Alegnago/cockpit/video_frames/video_contrasto.jpg

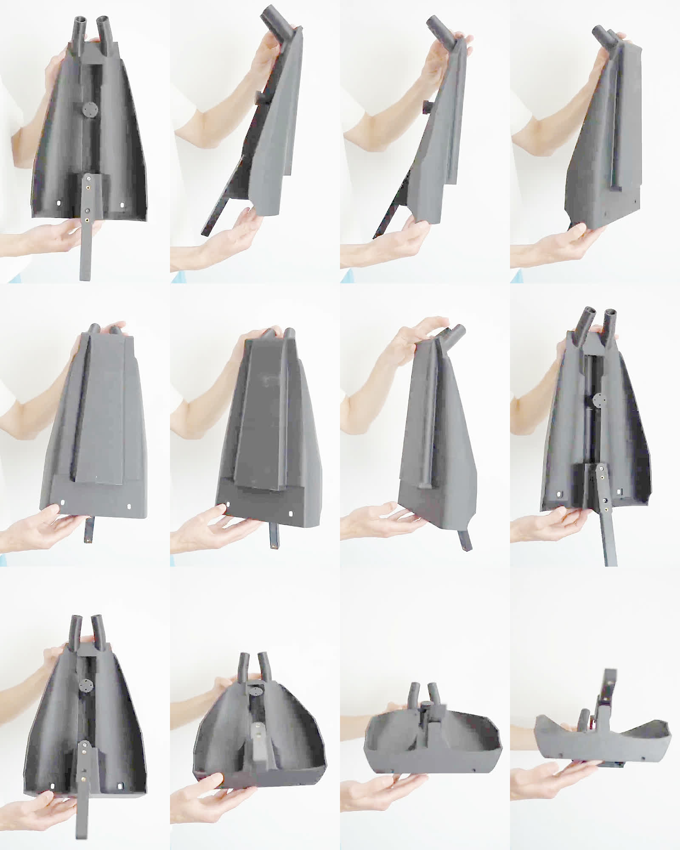
video_frames/video_contrasto.jpg
