Alegnago/cockpit/viewer/ref/sotto.jpg

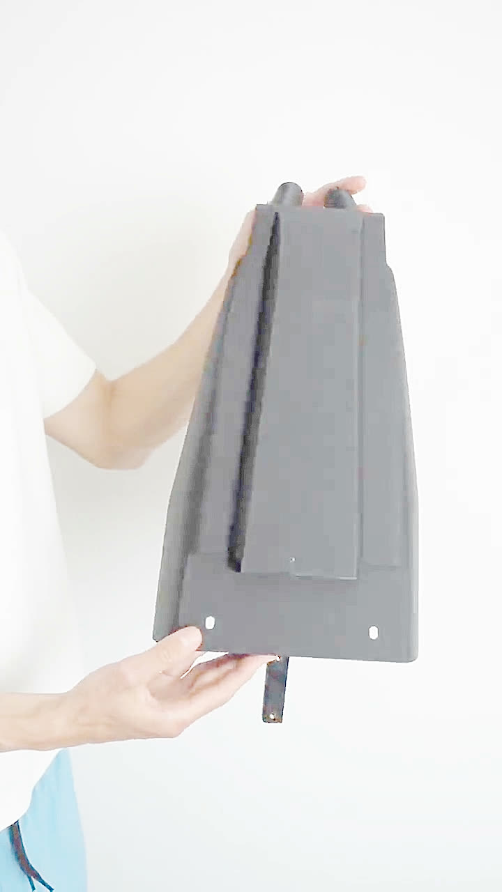
viewer/ref/sotto.jpg
