Alegnago/cockpit/out/assieme_front.png

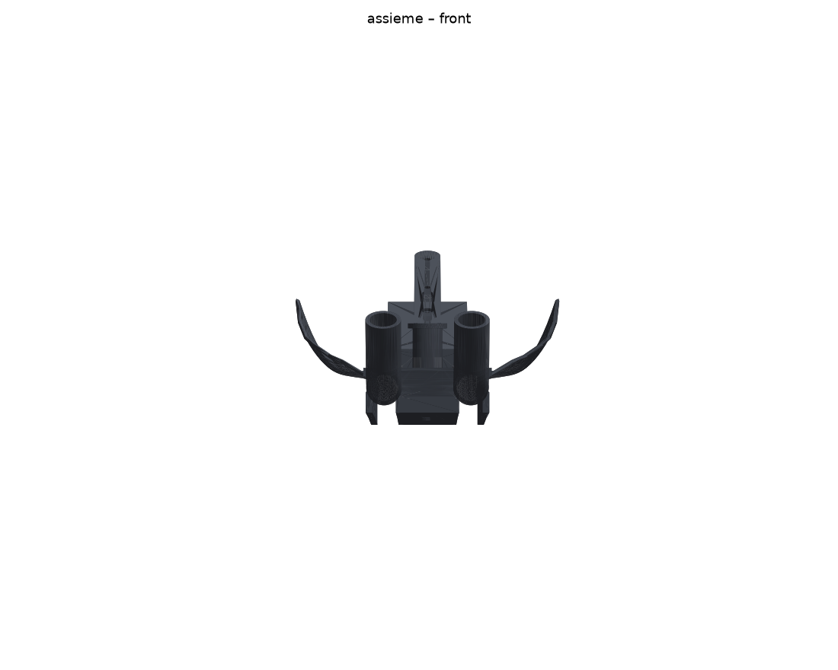
out/assieme_front.png
