Alegnago/cockpit/out/assieme_iso.png

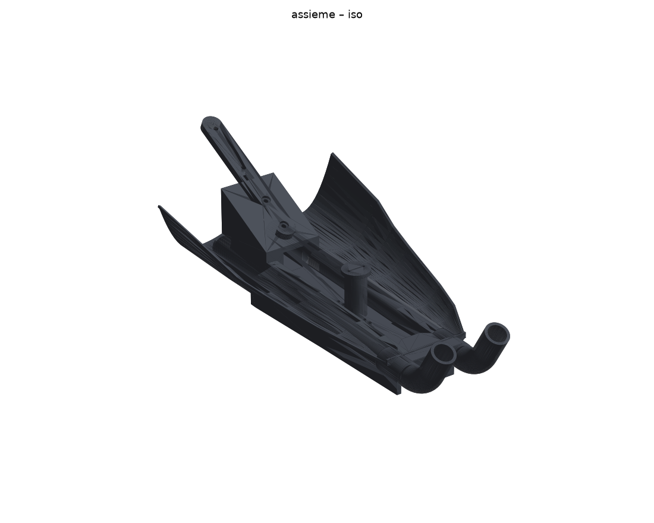
out/assieme_iso.png
