Alegnago/cockpit/out/assieme_side.png

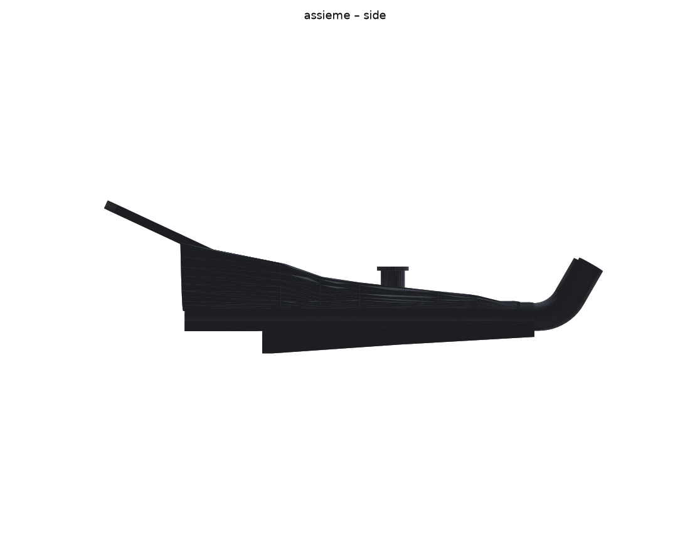
out/assieme_side.png
