Alegnago/cockpit/out/assieme_top.png

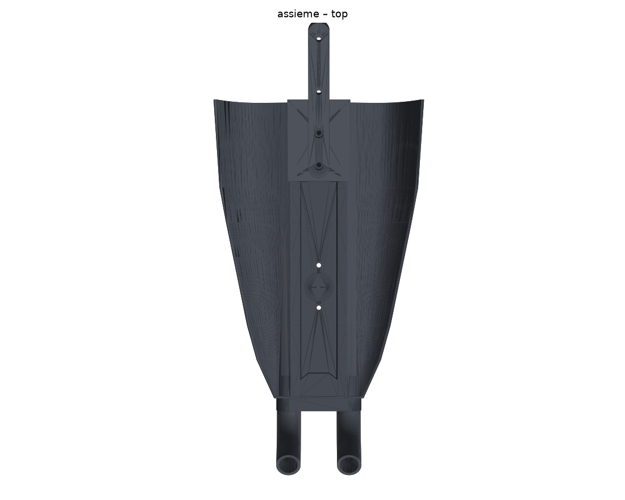
out/assieme_top.png
