Alegnago/cockpit/out/assieme_under.png

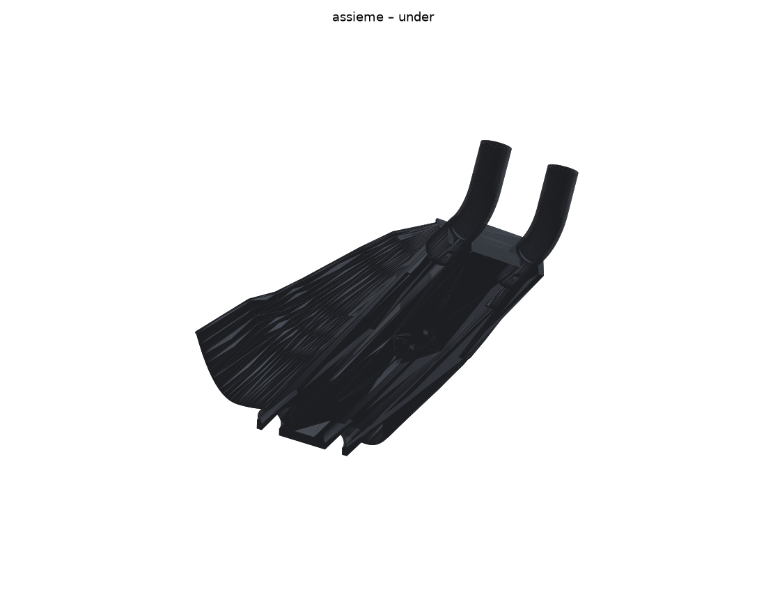
out/assieme_under.png
