Alegnago/cockpit/out/P3_tubo_punta_dx_front.png

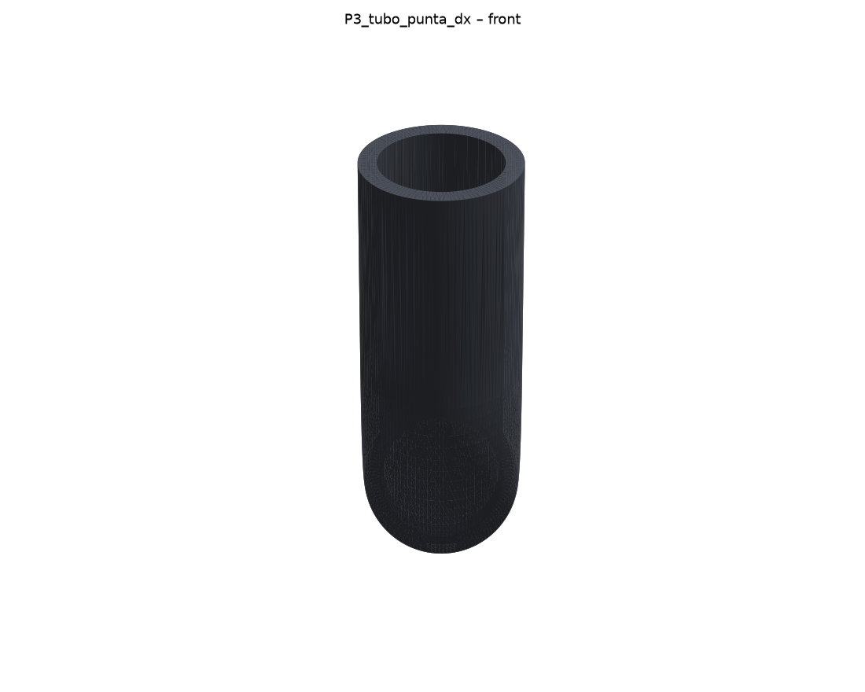
out/P3_tubo_punta_dx_front.png
