Alegnago/cockpit/out/P3_tubo_punta_dx_iso.png

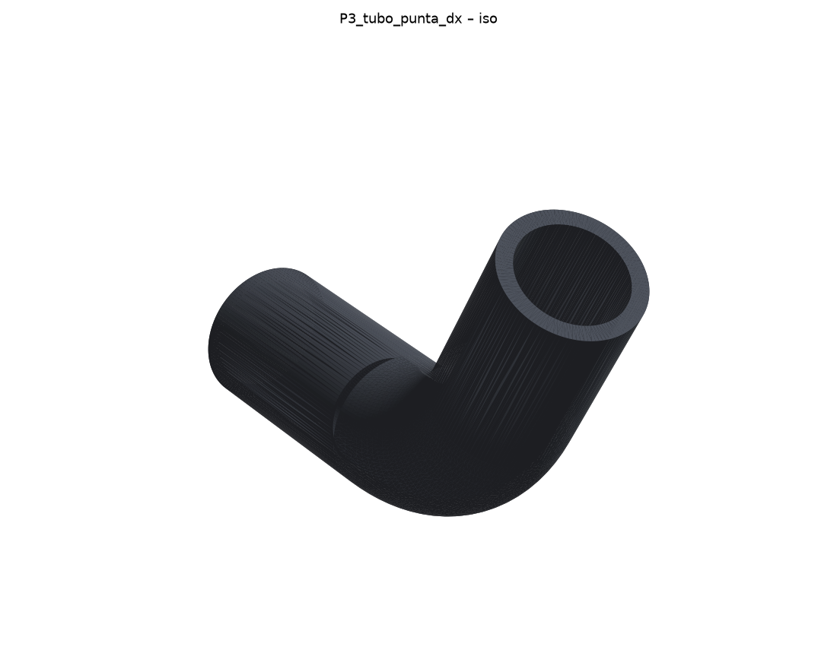
out/P3_tubo_punta_dx_iso.png
