Alegnago/cockpit/out/P3_tubo_punta_dx_side.png

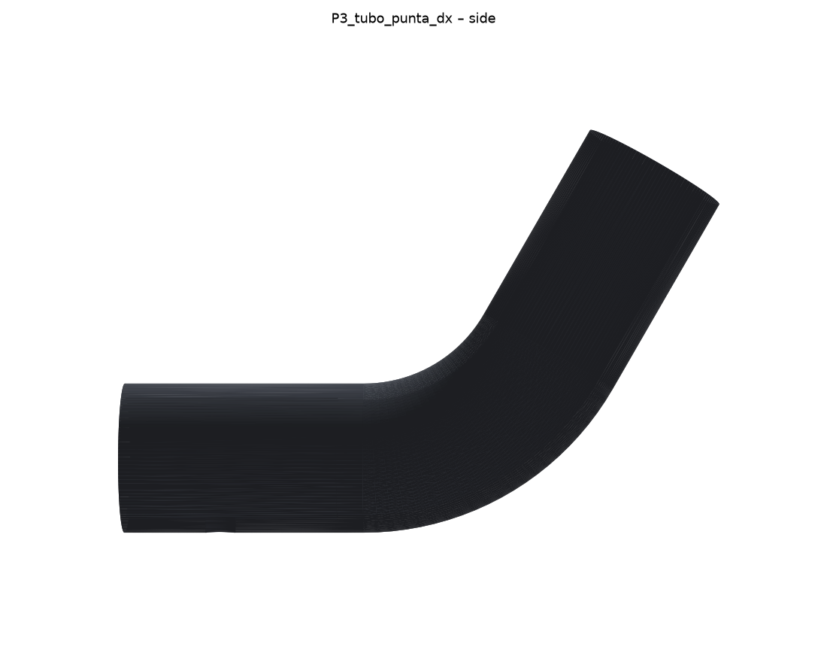
out/P3_tubo_punta_dx_side.png
