Alegnago/cockpit/out/P3_tubo_punta_dx_under.png

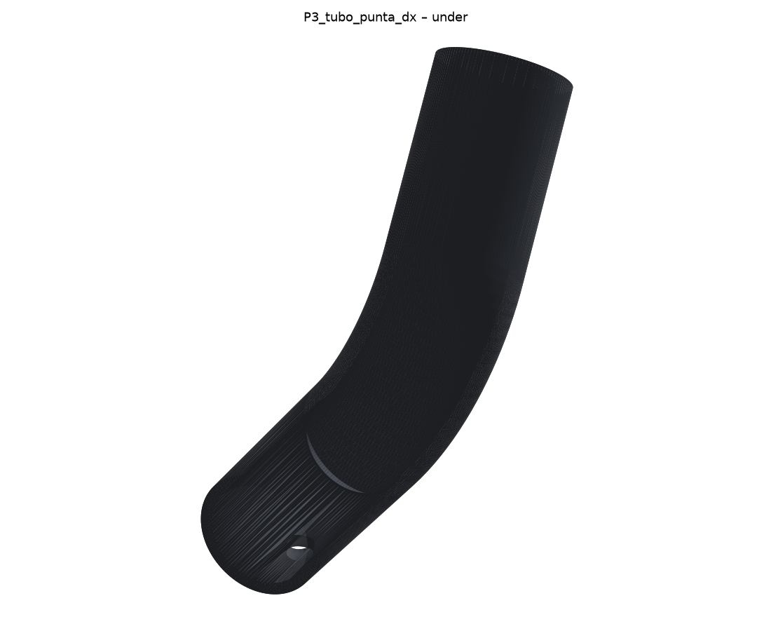
out/P3_tubo_punta_dx_under.png
