Alegnago/cockpit/video_frames/confronto_lato.jpg

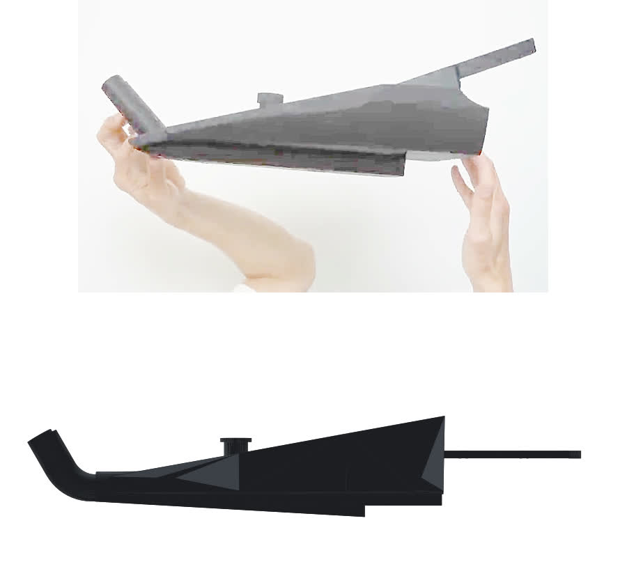
video_frames/confronto_lato.jpg
