Alegnago/cockpit/viewer/ref/alto.jpg

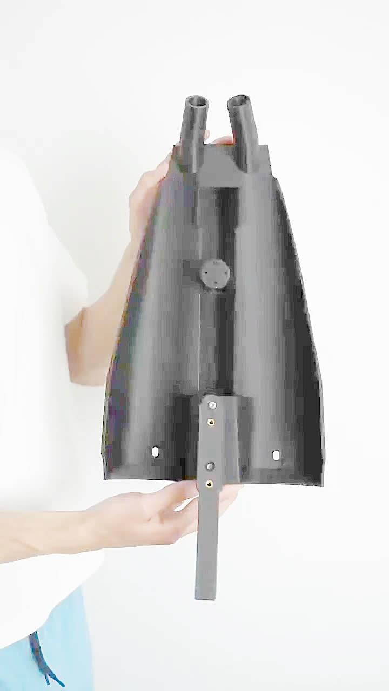
viewer/ref/alto.jpg
