Alegnago/cockpit/viewer/ref/lato.jpg

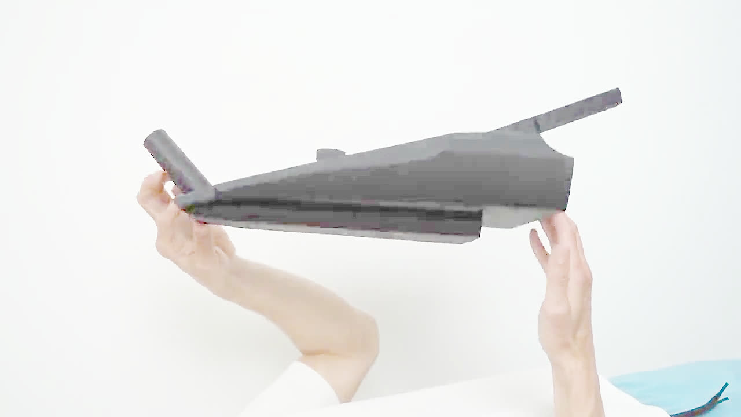
viewer/ref/lato.jpg
