Alegnago/cockpit/out/P0_test_clip.step

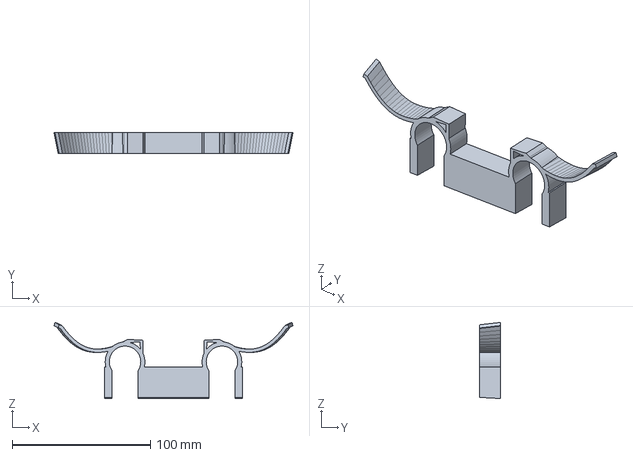
[picture p15: CAD file, 2026-10-28]
out/P0_test_clip.step
172.7 x 15.0 x 55.0 mm
