Alegnago/cockpit/out/P2_vassoio_posteriore.step

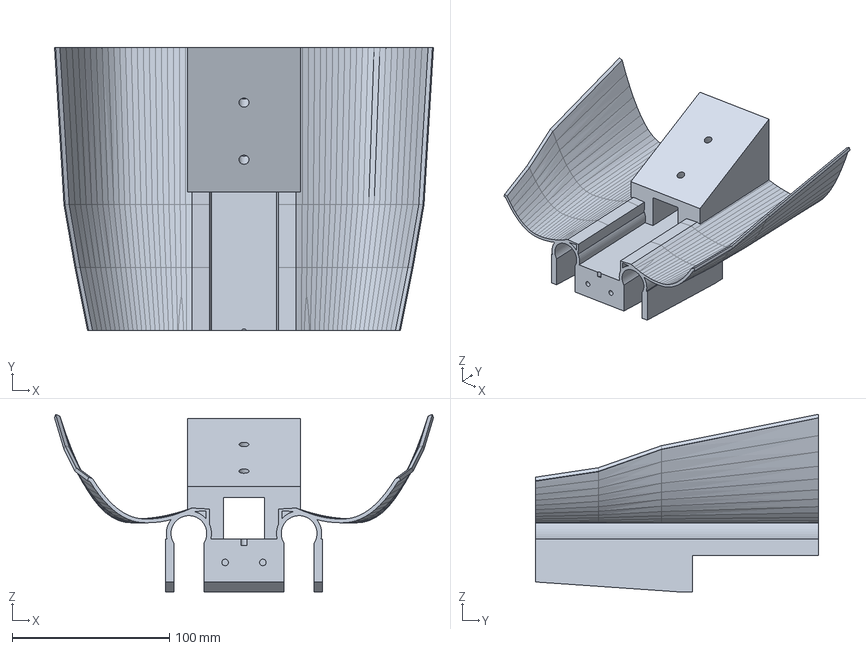
[picture p16: CAD file, 2026-10-28]
out/P2_vassoio_posteriore.step
240.7 x 180.0 x 112.7 mm
