Alegnago/cockpit/out/assieme.step

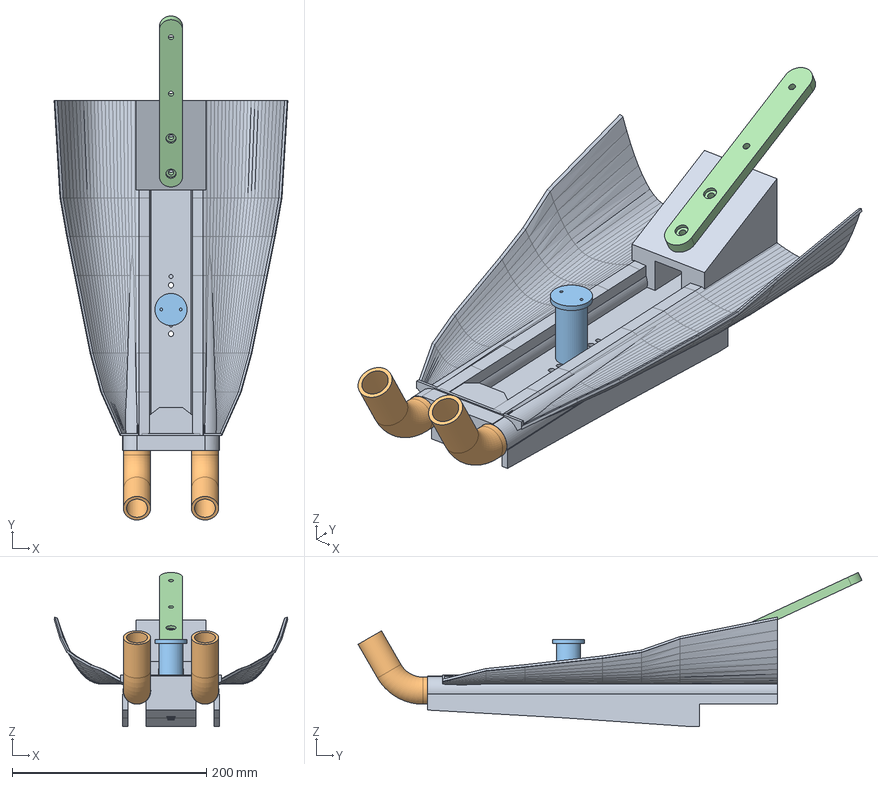
[picture p17: CAD file, 2026-10-28]
out/assieme.step
240.7 x 519.0 x 158.7 mm
