Alegnago/cockpit/out/P3_tubo_punta_sx.step

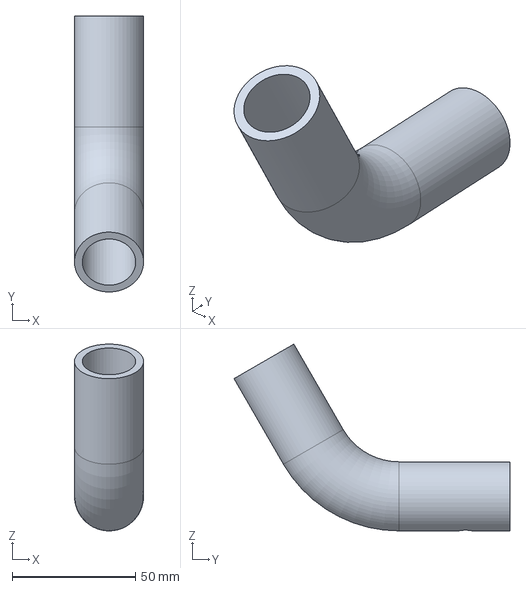
[picture p18: CAD file, 2026-10-28]
out/P3_tubo_punta_sx.step
28.0 x 111.8 x 75.6 mm
