Alegnago/cockpit/out/P5_braccio_borraccia.step

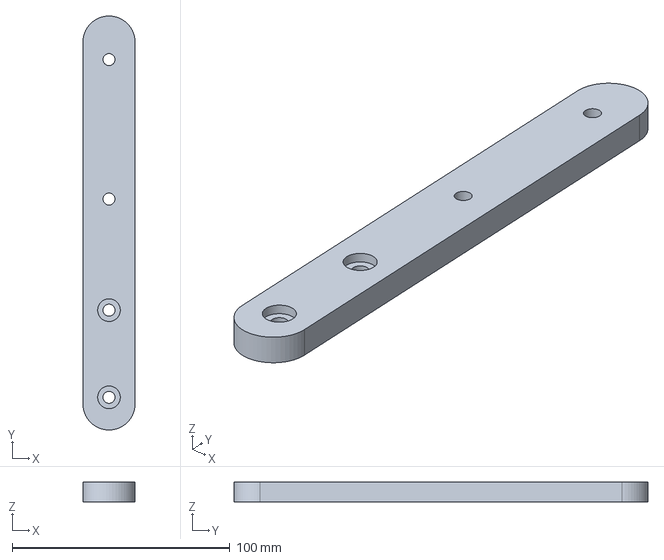
[picture p19: CAD file, 2026-10-28]
out/P5_braccio_borraccia.step
24.0 x 190.0 x 9.00 mm
