Alegnago/cockpit/out/P4_colonnina_computer.step

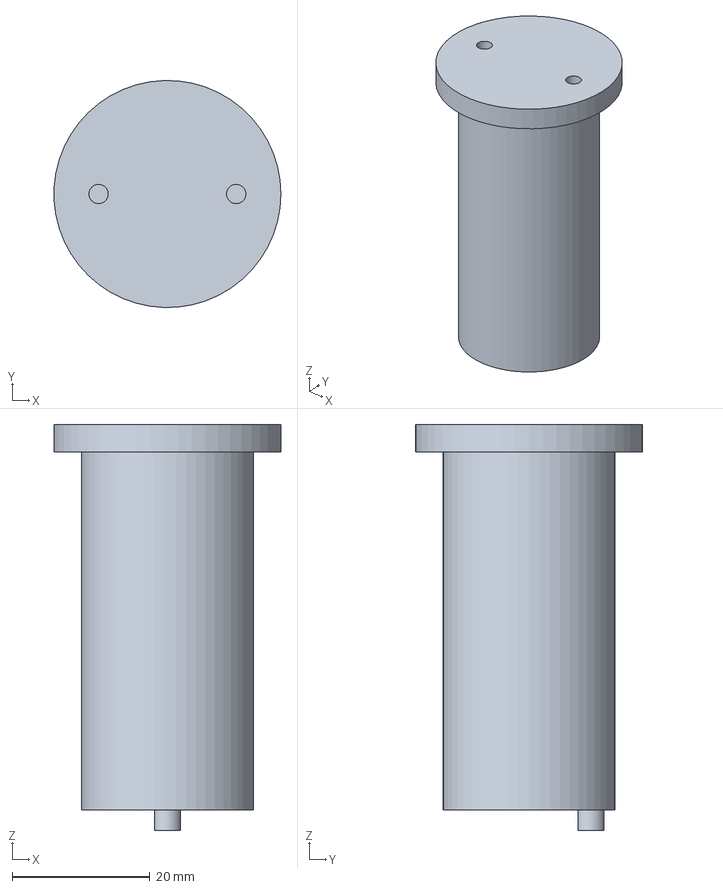
[picture p20: CAD file, 2026-10-28]
out/P4_colonnina_computer.step
33.0 x 33.0 x 59.0 mm
