Alegnago/cockpit/out/P1_vassoio_anteriore.step

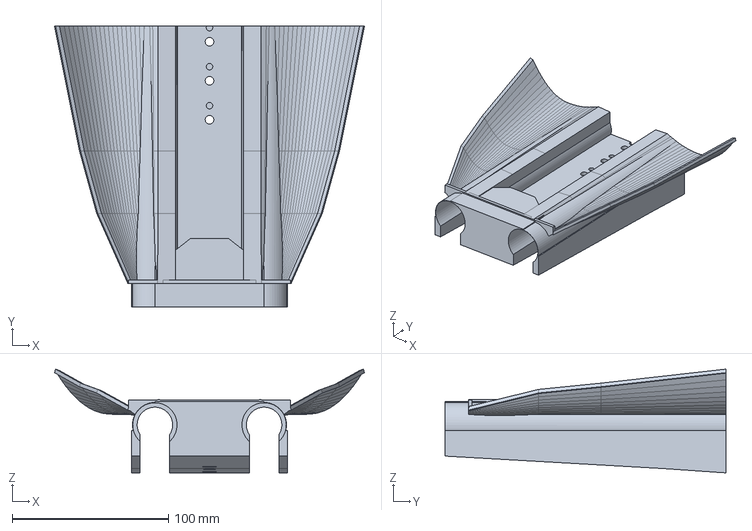
[picture p21: CAD file, 2026-10-28]
out/P1_vassoio_anteriore.step
198.7 x 180.0 x 66.5 mm
