Alegnago/cockpit/(list of files, cad)

Other CAD files:
out/P3_tubo_punta_dx.step
out/P0_test_clip.stl
out/P1_vassoio_anteriore.stl
out/P2_vassoio_posteriore.stl
out/P3_tubo_punta_dx.stl
out/P3_tubo_punta_sx.stl
out/P4_colonnina_computer.stl
out/P5_braccio_borraccia.stl
out/assieme.stl
