Alegnago/cockpit/out/P0_test_clip_front.png

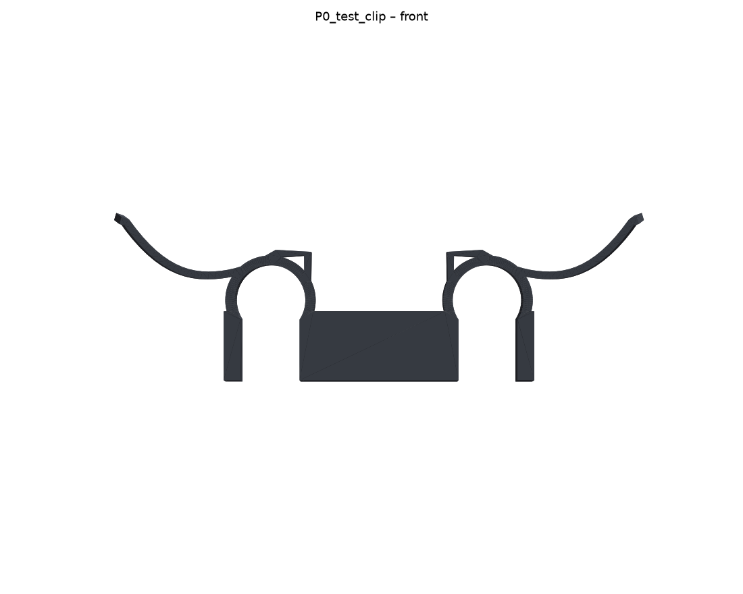
out/P0_test_clip_front.png
