Alegnago/cockpit/out/P0_test_clip_iso.png

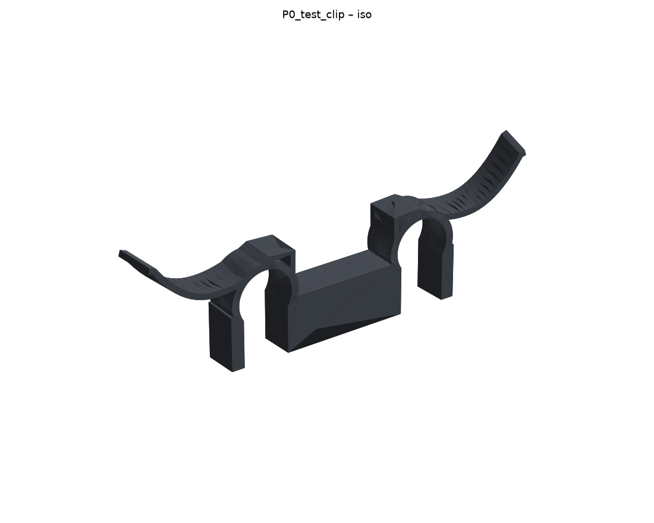
out/P0_test_clip_iso.png
