Alegnago/cockpit/out/P0_test_clip_side.png

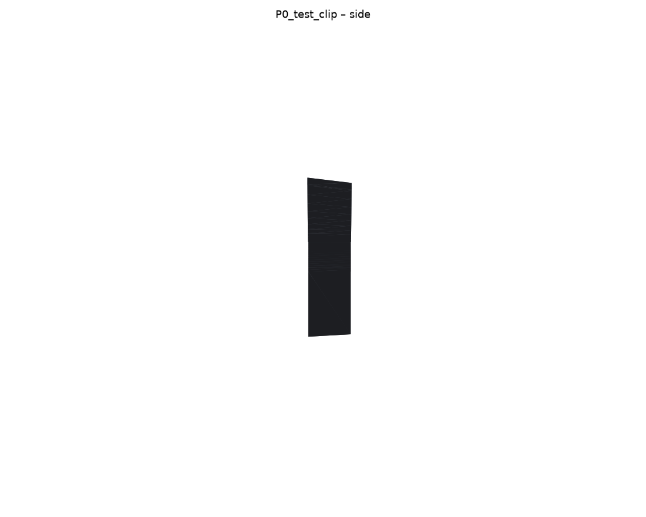
out/P0_test_clip_side.png
