Alegnago/cockpit/out/P0_test_clip_top.png

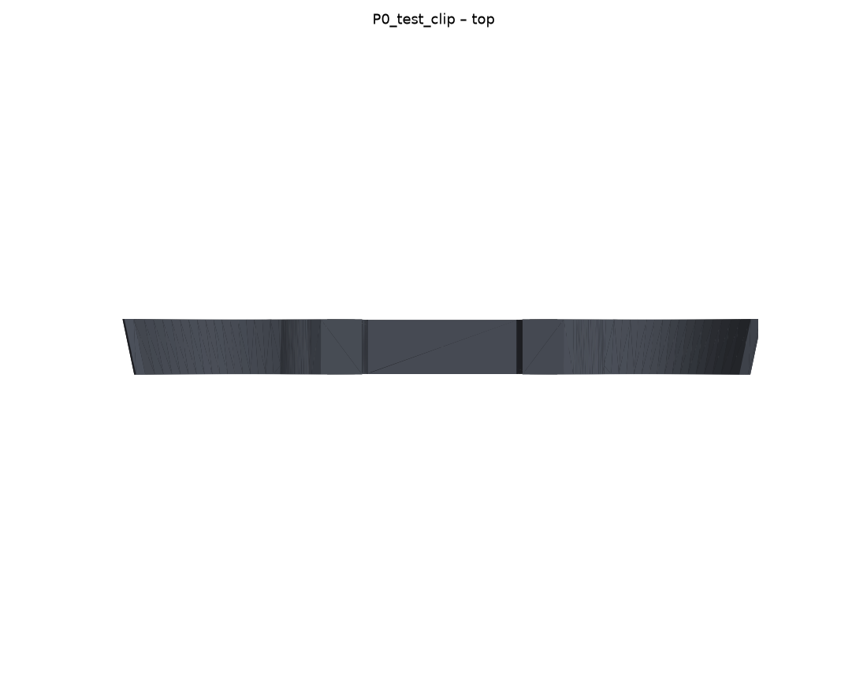
out/P0_test_clip_top.png
