Alegnago/cockpit/out/P0_test_clip_under.png

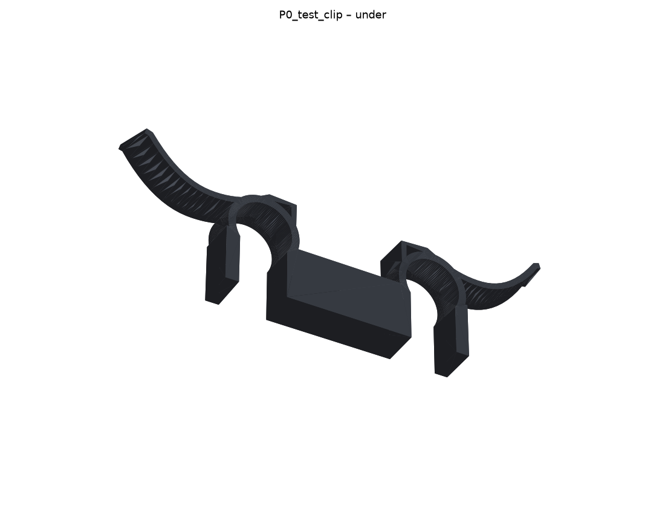
out/P0_test_clip_under.png
