Alegnago/cockpit/(commit log)

2026-10-28 Cockpit triathlon stampabile per Canyon Speedmax CF (v0.5)
    Modello parametrico CadQuery ricostruito da foto e video a 360°: vasca a
    cuneo con lobi divergenti, chiglia con sedi a scatto per le estensioni,
    tubi punta a 60°, braccio borraccia fisso a 25°. Include STEP/STL,
    visualizzatore 3D con disegni tecnici e confronto con i frame del video.
    [P0_test_clip.step, P0_test_clip.stl, P1_vassoio_anteriore.step, P1_vassoio_anteriore.stl, P2_vassoio_posteriore.step, P2_vassoio_posteriore.stl, P3_tubo_punta_dx.step, P3_tubo_punta_dx.stl]
2026-10-28 Aggiorna render v0.5 e README con struttura del repo
    [P0_test_clip.step, P1_vassoio_anteriore.step, P2_vassoio_posteriore.step, P3_tubo_punta_dx.step, P3_tubo_punta_sx.step, P4_colonnina_computer.step, P5_braccio_borraccia.step, assieme.step]
2026-10-28 v0.6: incavi per gli avambracci e profilo misurato dal video
    - sostituisce i lobi convessi con incavi concavi ai lati del canale
    - pareti e chiglia ricalibrate sui contorni estratti dai frame (trace.py, compare.py)
    - visualizzatore: contorni dal video sovrapposti al 3D e ai disegni, vista ortogonale
    [P0_test_clip.step, P0_test_clip.stl, P1_vassoio_anteriore.step, P1_vassoio_anteriore.stl, P2_vassoio_posteriore.step, P2_vassoio_posteriore.stl, P3_tubo_punta_dx.step, P3_tubo_punta_sx.step]
2026-10-28 Sito statico per Vercel con download dei file di stampa
    - build-site.mjs crea site/ (documento HTML completo + STL/STEP in files/)
    - vercel.json: build senza dipendenze, output site/, download come allegato
    - visualizzatore: sezione download visibile solo sul sito
